power-zhy/SystemOnFPGA/TODO_list.txt

修复keyboard在FSM AUTO下无法使用的问题
keyboard数据写入出错BUG

UART等设备的接入检测（目前UART在未连接时会产生一个校验错误）（可通过UART信号上拉解决？）
将时钟生成器作为0号外设

CMU内部存在闭环逻辑电路，导致时序分析失败
