power-zhy/SystemOnFPGA/doc/SystemOnFPGA_Poster.pdf

# Computer System on FPGA

## Zhao Hongyu, Long Peng, Ni Junyang @ZJU

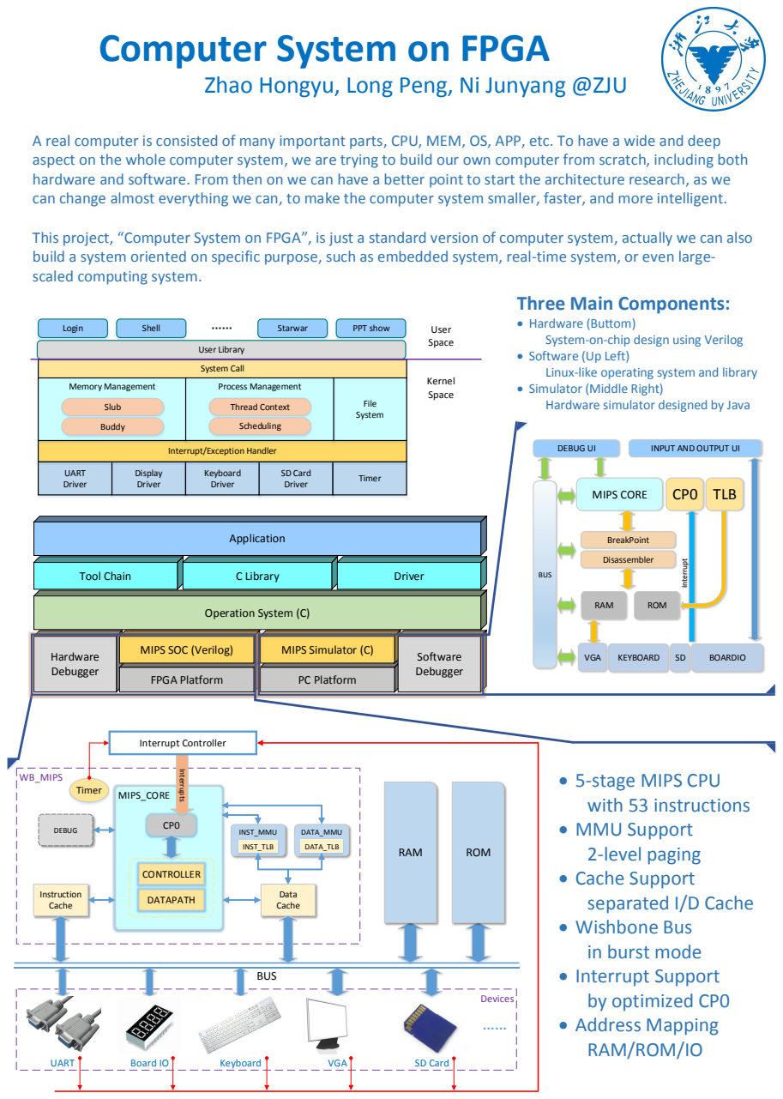
[picture p6: page 1]
Hardware; Debugger; FPGA Platform; PC Platform; MIPS Simulator (C); Software Debugger; Operation System (C); Tool Chain; C Library; Driver; Application; WB_MIPS; Devices; MIPS_CORE; Instruction Cache; Data Cache; DEBUG; INST_MMU; DATA_MMU; CONTROLLER; DATAPATH; INST_TLB; DATA_TLB; Interrupts; RAM; ROM; Interrupt Controller; Timer; UART; Keyboard; VGA; SD Card; BUS; Board IO; MIPS CORE; Disassembler; DEBUG UI; TLB; BreakPoint; KEYBOARD; BOARDIO Interrupt; System Call; Display Driver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

A real computer is consisted of many important parts, CPU, MEM, OS, APP, etc. To have a wide and deep
aspect on the whole computer system, we are trying to build our own computer from scratch, including both
hardware and software. From then on we can have a better point to start the architecture research, as we
can change almost everything we can, to make the computer system smaller, faster, and more intelligent.

This project,
build a system oriented on specific purpose, such as embedded system, real-time system, or even large-
scaled computing system.

Computer System on FPGA

, is just a standard version of computer system, actually we can also

Three Main Components:
• Hardware (Buttom)
System-on-chip design using Verilog
• Software (Up Left)
Linux-like operating system and library
• Simulator (Middle Right)
Hardware simulator designed by Java

INPUT AND OUTPUT UI

Interrupt/Exception Handler

MIPS SOC (Verilog)

• 5-stage MIPS CPU
with 53 instructions
• MMU Support
2-level paging
• Cache Support
separated I/D Cache
• Wishbone Bus
in burst mode
• Interrupt Support
by optimized CP0
• Address Mapping
RAM/ROM/IO
