power-zhy/SystemOnFPGA/cpu/mips/wb_mips.v

`include "define.vh"


/**
 * MIPS 5-stage pipeline CPU with wishbone connection interfaces.
 * Author: Zhao, Hongyu  <power_zhy@foxmail.com>
 */
module wb_mips (
	input wire clk,  // main clock
	input wire rst,  // synchronous reset
	// debug
	`ifdef DEBUG
	input wire debug_en,  // debug enable
	input wire debug_step,  // debug step clock
	input wire [6:0] debug_addr,  // debug address
	output wire [31:0] debug_data,  // debug data
	`endif
	// wishbone master interfaces for ICMU
	input wire icmu_clk_i,
	output wire icmu_cyc_o,
	output wire icmu_stb_o,
	output wire [31:2] icmu_addr_o,
	output wire [2:0] icmu_cti_o,
	output wire [1:0] icmu_bte_o,
	output wire [3:0] icmu_sel_o,
	output wire icmu_we_o,
	input wire [31:0] icmu_data_i,
	output wire [31:0] icmu_data_o,
	input wire icmu_ack_i,
	input wire icmu_err_i,
	// wishbone master interfaces for DCMU
	input wire dcmu_clk_i,
	output wire dcmu_cyc_o,
	output wire dcmu_stb_o,
	output wire [31:2] dcmu_addr_o,
	output wire [2:0] dcmu_cti_o,
	output wire [1:0] dcmu_bte_o,
	output wire [3:0] dcmu_sel_o,
	output wire dcmu_we_o,
	input wire [31:0] dcmu_data_i,
	output wire [31:0] dcmu_data_o,
	input wire dcmu_ack_i,
	input wire dcmu_err_i,
	// interrupt interfaces
	input wire [30:1] ir_map,  // device interrupt signals
	output wire wd_rst  // watch dog reset, must not affect the global reset signal
	);
	
	`include "cpu_define.vh"
	parameter
		CLK_FREQ = 100;  // main clock frequency in MHz
	parameter
		IT_LINE_NUM = 16,  // number of lines in instruction TLB, must be the power of 2
		DT_LINE_NUM = 16,  // number of lines in data TLB, must be the power of 2
		IC_LINE_NUM = 64,  // number of lines in instruction cache, must be the power of 2
		DC_LINE_NUM = 64;  // number of lines in data cache, must be the power of 2
	localparam
		PAGE_ADDR_BITS = 12;  // address length inside one memory page
	
	// MMU signals
	wire user_mode;
	wire mmu_en, mmu_inv;
	wire [31:PAGE_ADDR_BITS] pdb_addr;
	
	// instruction signals
	wire inst_ren, inst_suspend;
	wire immu_stall, icache_stall, inst_stall;
	wire [31:PAGE_ADDR_BITS] inst_addr_logical, inst_addr_physical;
	wire [PAGE_ADDR_BITS-1:0] inst_addr_page;
	wire [31:0] inst_data;
	wire inst_unalign, inst_bus_err, inst_page_fault;
	wire inst_unauth_user, inst_unauth_exec;
	wire ic_en, ic_lock;
	wire ic_inv;
	wire itlb_ren;
	wire [31:0] itlb_addr;
	reg itlb_ack;
	reg [31:0] itlb_data;
	
	// memory signals
	wire mem_ren, mem_wen, mem_suspend;
	wire dmmu_stall, dcache_stall, mem_stall;
	wire [1:0] mem_type;
	wire mem_ext;
	wire [31:PAGE_ADDR_BITS] mem_addr_logical, mem_addr_physical;
	wire [PAGE_ADDR_BITS-1:0] mem_addr_page;
	reg [31:0] mem_data_r;
	wire [31:0] mem_data_w;
	wire mem_unalign, mem_bus_err, mem_page_fault;
	wire mem_unauth_user, mem_unauth_write;
	wire dc_en, dc_lock;
	wire dc_inv;
	wire dtlb_ren;
	wire [31:0] dtlb_addr;
	reg dtlb_ack;
	reg [31:0] dtlb_data;
	
	wire exception;
	wire inst_auth_user, inst_auth_exec;
	wire mem_auth_user, mem_auth_write;
	
	// mips core
	assign
		inst_stall = immu_stall | icache_stall,
		mem_stall = immu_stall | dmmu_stall | dcache_stall,
		inst_suspend = exception | immu_stall | inst_page_fault | inst_unauth_user | inst_unauth_exec,
		mem_suspend = exception | mem_page_fault | mem_unauth_user | mem_unauth_write;
	
	mips_core #(
		.CLK_FREQ(CLK_FREQ),
		.PAGE_ADDR_BITS(PAGE_ADDR_BITS)
		) MIPS_CORE (
		.clk(clk),
		.rst(rst),
		`ifdef DEBUG
		.debug_en(debug_en),
		.debug_step(debug_step),
		.debug_addr(debug_addr),
		.debug_data(debug_data),
		`endif
		.user_mode(user_mode),
		.mmu_en(mmu_en),
		.mmu_inv(mmu_inv),
		.pdb_addr(pdb_addr),
		.inst_ren(inst_ren),
		.inst_stall(inst_stall),
		.inst_addr({inst_addr_logical, inst_addr_page}),
		.inst_data(inst_data),
		.inst_unalign(inst_unalign),
		.inst_bus_err(inst_bus_err),
		.inst_page_fault(inst_page_fault),
		.inst_unauth_user(inst_unauth_user),
		.inst_unauth_exec(inst_unauth_exec),
		.ic_lock(ic_lock),
		.ic_inv(ic_inv),
		.mem_ren(mem_ren),
		.mem_wen(mem_wen),
		.mem_stall(mem_stall),
		.mem_type(mem_type),
		.mem_ext(mem_ext),
		.mem_addr({mem_addr_logical, mem_addr_page}),
		.mem_dout(mem_data_w),
		.mem_din(mem_data_r),
		.mem_unalign(mem_unalign),
		.mem_bus_err(mem_bus_err),
		.mem_page_fault(mem_page_fault),
		.mem_unauth_user(mem_unauth_user),
		.mem_unauth_write(mem_unauth_write),
		.dc_lock(dc_lock),
		.dc_inv(dc_inv),
		.ir_map(ir_map),
		.wd_rst(wd_rst),
		.exception(exception)
		);
	
	`ifndef NO_MMU
	// instruction MMU
	mmu #(
		.LINE_NUM(IT_LINE_NUM)
		) IMMU (
		.clk(clk),
		.rst(rst | wd_rst | mmu_inv),
		.suspend(1'b0),
		.en_mmu(mmu_en & (inst_ren | ic_inv)),
		.stall(immu_stall),
		.pdb_addr(pdb_addr),
		.logical(inst_addr_logical),
		.physical(inst_addr_physical),
		.page_fault(inst_page_fault),
		.auth_user(inst_auth_user),
		.auth_exec(inst_auth_exec),
		.auth_write(),
		.en_cache(ic_en),
		.ren(itlb_ren),
		.addr(itlb_addr),
		.ack(itlb_ack),
		.data(itlb_data)
		);
	
	assign
		inst_unauth_user = inst_ren & ~inst_auth_user & user_mode,
		inst_unauth_exec = inst_ren & ~inst_auth_exec;
	
	// data MMU
	mmu #(
		.LINE_NUM(DT_LINE_NUM)
		) DMMU (
		.clk(clk),
		.rst(rst | wd_rst | mmu_inv),
		.suspend(1'b0),
		.en_mmu(mmu_en & (mem_ren | mem_wen | dc_inv)),
		.stall(dmmu_stall),
		.pdb_addr(pdb_addr),
		.logical(mem_addr_logical),
		.physical(mem_addr_physical),
		.page_fault(mem_page_fault),
		.auth_user(mem_auth_user),
		.auth_exec(),
		.auth_write(mem_auth_write),
		.en_cache(dc_en),
		.ren(dtlb_ren),
		.addr(dtlb_addr),
		.ack(dtlb_ack),
		.data(dtlb_data)
		);
	
	assign
		mem_unauth_user = (mem_ren | mem_wen) & ~mem_auth_user & user_mode,
		mem_unauth_write = mem_wen & ~mem_auth_write;
	
	`else
	assign
		immu_stall = 0,
		inst_addr_physical = inst_addr_logical,
		inst_page_fault = 0,
		inst_auth_user = 0,
		inst_auth_exec = 0,
		ic_en = 0,
		itlb_ren = 0,
		itlb_addr = 0,
		dmmu_stall = 0,
		mem_addr_physical = mem_addr_logical,
		mem_page_fault = 0,
		mem_auth_user = 0,
		mem_auth_write = 0,
		dc_en = 0,
		dtlb_ren = 0,
		dtlb_addr = 0;
	
	`define NO_IC
	`define NO_DC
	
	`endif
	
	`ifndef NO_IC
	// instruction cache
	wb_cmu #(
		.LINE_NUM(IC_LINE_NUM),
		.LINE_WORDS(4)
		) ICMU (
		.clk(clk),
		.rst(rst | wd_rst),
		.suspend(inst_suspend),
		.en_cache(ic_en),
		.addr_rw({inst_addr_physical, inst_addr_page}),
		.addr_type(MEM_TYPE_WORD),
		.sign_ext(1'b0),
		.en_r(inst_ren),
		.data_r(inst_data),
		.en_w(1'b0),
		.data_w(0),
		.en_f(ic_inv),
		.lock(ic_lock),
		.stall(icache_stall),
		.align_err(inst_unalign),
		.bus_err(inst_bus_err),
		.wbm_clk_i(icmu_clk_i),
		.wbm_cyc_o(icmu_cyc_o),
		.wbm_stb_o(icmu_stb_o),
		.wbm_addr_o(icmu_addr_o),
		.wbm_cti_o(icmu_cti_o),
		.wbm_bte_o(icmu_bte_o),
		.wbm_sel_o(icmu_sel_o),
		.wbm_we_o(icmu_we_o),
		.wbm_data_i(icmu_data_i),
		.wbm_data_o(icmu_data_o),
		.wbm_ack_i(icmu_ack_i),
		.wbm_err_i(icmu_err_i)
		);
	`else
	wb_cpu_conn ICMU (
		.clk(clk),
		.rst(rst | wd_rst),
		.suspend(inst_suspend),
		.addr_rw({inst_addr_physical, inst_addr_page}),
		.addr_type(MEM_TYPE_WORD),
		.sign_ext(1'b0),
		.en_r(inst_ren),
		.data_r(inst_data),
		.en_w(1'b0),
		.data_w(0),
		.lock(ic_lock),
		.stall(icache_stall),
		.align_err(inst_unalign),
		.bus_err(inst_bus_err),
		.wbm_clk_i(icmu_clk_i),
		.wbm_cyc_o(icmu_cyc_o),
		.wbm_stb_o(icmu_stb_o),
		.wbm_addr_o(icmu_addr_o),
		.wbm_cti_o(icmu_cti_o),
		.wbm_bte_o(icmu_bte_o),
		.wbm_sel_o(icmu_sel_o),
		.wbm_we_o(icmu_we_o),
		.wbm_data_i(icmu_data_i),
		.wbm_data_o(icmu_data_o),
		.wbm_ack_i(icmu_ack_i),
		.wbm_err_i(icmu_err_i)
		);
	`endif
	
	reg dcmu_en_cache;
	reg [31:0] dcmu_addr_rw;
	reg [1:0] dcmu_addr_type;
	reg dcmu_sign_ext;
	reg dcmu_en_r;
	wire [31:0] dcmu_data_r;
	reg dcmu_en_w;
	reg [31:0] dcmu_data_w;
	reg dcmu_en_f;
	reg dcmu_lock;
	
	always @(*) begin
		dcmu_en_cache = 0;
		dcmu_addr_rw = 0;
		dcmu_addr_type = 0;
		dcmu_sign_ext = 0;
		dcmu_en_r = 0;
		dcmu_en_w = 0;
		dcmu_data_w = 0;
		dcmu_en_f = 0;
		dcmu_lock = 0;
		itlb_ack = 0;
		itlb_data = 0;
		dtlb_ack = 0;
		dtlb_data = 0;
		mem_data_r = 0;
		if (immu_stall) begin
			dcmu_en_cache = 1;
			dcmu_addr_rw = itlb_addr;
			dcmu_addr_type = MEM_TYPE_WORD;
			dcmu_en_r = itlb_ren;
			itlb_ack = itlb_ren & ~dcache_stall;
			itlb_data = dcmu_data_r;
		end
		else if (dmmu_stall) begin
			dcmu_en_cache = 1;
			dcmu_addr_rw = dtlb_addr;
			dcmu_addr_type = MEM_TYPE_WORD;
			dcmu_en_r = dtlb_ren;
			dtlb_ack = dtlb_ren & ~dcache_stall;
			dtlb_data = dcmu_data_r;
		end
		else begin
			dcmu_en_cache = dc_en;
			dcmu_addr_rw = {mem_addr_physical, mem_addr_page};
			dcmu_addr_type = mem_type;
			dcmu_sign_ext = mem_ext;
			dcmu_en_r = mem_ren;
			dcmu_en_w = mem_wen;
			dcmu_data_w = mem_data_w;
			dcmu_en_f = dc_inv;
			dcmu_lock = dc_lock;
			mem_data_r = dcmu_data_r;
		end
	end
	
	`ifndef NO_DC
	// data cache
	wb_cmu #(
		.LINE_NUM(DC_LINE_NUM),
		.LINE_WORDS(4)
		) DCMU (
		.clk(clk),
		.rst(rst | wd_rst),
		.suspend(mem_suspend),
		.en_cache(dcmu_en_cache),
		.addr_rw(dcmu_addr_rw),
		.addr_type(dcmu_addr_type),
		.sign_ext(dcmu_sign_ext),
		.en_r(dcmu_en_r),
		.data_r(dcmu_data_r),
		.en_w(dcmu_en_w),
		.data_w(dcmu_data_w),
		.en_f(dcmu_en_f),
		.lock(dcmu_lock),
		.stall(dcache_stall),
		.align_err(mem_unalign),
		.bus_err(mem_bus_err),
		.wbm_clk_i(dcmu_clk_i),
		.wbm_cyc_o(dcmu_cyc_o),
		.wbm_stb_o(dcmu_stb_o),
		.wbm_addr_o(dcmu_addr_o),
		.wbm_cti_o(dcmu_cti_o),
		.wbm_bte_o(dcmu_bte_o),
		.wbm_sel_o(dcmu_sel_o),
		.wbm_we_o(dcmu_we_o),
		.wbm_data_i(dcmu_data_i),
		.wbm_data_o(dcmu_data_o),
		.wbm_ack_i(dcmu_ack_i),
		.wbm_err_i(dcmu_err_i)
		);
	`else
	wb_cpu_conn DCMU (
		.clk(clk),
		.rst(rst | wd_rst),
		.suspend(mem_suspend),
		.addr_rw(dcmu_addr_rw),
		.addr_type(dcmu_addr_type),
		.sign_ext(dcmu_sign_ext),
		.en_r(dcmu_en_r),
		.data_r(dcmu_data_r),
		.en_w(dcmu_en_w),
		.data_w(dcmu_data_w),
		.lock(dcmu_lock),
		.stall(dcache_stall),
		.align_err(mem_unalign),
		.bus_err(mem_bus_err),
		.wbm_clk_i(dcmu_clk_i),
		.wbm_cyc_o(dcmu_cyc_o),
		.wbm_stb_o(dcmu_stb_o),
		.wbm_addr_o(dcmu_addr_o),
		.wbm_cti_o(dcmu_cti_o),
		.wbm_bte_o(dcmu_bte_o),
		.wbm_sel_o(dcmu_sel_o),
		.wbm_we_o(dcmu_we_o),
		.wbm_data_i(dcmu_data_i),
		.wbm_data_o(dcmu_data_o),
		.wbm_ack_i(dcmu_ack_i),
		.wbm_err_i(dcmu_err_i)
		);
	`endif
	
endmodule
