power-zhy/SystemOnFPGA/(commit log)

2014-11-17 Do not using suspend in MMU to avoid close logic loop.
    [SystemOnFPGA_Nexys3.v, cp0.v, wb_cmu.v, wb_mips.v]
2014-11-23 BUG fix on MMU with user authority bit.
    [cp0.v, mips_core.v, mmu.v, wb_mips.v]
2014-11-23 BUG fix on watch dog.
    [cp0.v]
2014-12-15 Bug fix on SRRV's data forwarding.
    [controller.v, rom.v]
2015-03-16 Try to add AnvylSword board support.
2015-04-19 Add bus error detection.
    [SystemOnFPGA_Nexys3.v, controller.v, cp0.v, datapath.v, mips_core.v, ppcm_core_nexys3.v, ram.v, rom.v]
2015-04-29 Rewrite UART module.
2015-09-05 Port project to sword board.
2015-09-12 Support ps2 with no clock host control. SRAM of sword still has some bugs.
    [SystemOnFPGA_Sword.v, ps2_host.v, test_frame_sword.v, wb_board_nexys3.v, wb_ps2.v]
2015-09-21 SRAM bug fix, add docs.
    [SystemOnFPGA_Sword.v, sram_core_sword.v, test_frame_sword.v, wb_sram_sword.v]
2015-12-24 Bug fix on ppcm's config.
    [SystemOnFPGA_Nexys3.v, SystemOnFPGA_Sword.v, psram_core_nexys3.v, wb_flash_sword.v, wb_memory_nexys3.v, wb_ppcm_nexys3.v, wb_psram_nexys3.v]
2015-12-25 Fix bugs running on Nexys3
    [SystemOnFPGA_Nexys3.v, SystemOnFPGA_Sword.v, board_disp_sword.v, mmu.v, seg_disp_nexys3.v, test_frame_nexys3.v, test_frame_sword.v, test_vga_nexys3.v]
